sampsonbrasseux421/zynq-vision-sorting/report/video_script.docx

演示视频文本化说明

《基于 Zynq-7020 机械臂的智能识别与分拣》

## 一、视频基本信息

文件名 | 11月3日 (1).mp4
分辨率 | 1280 × 720
帧率 | 30 fps
时长 | 2 分 16 秒（135.9 秒）
内容概要 | 操作者用 Xbox 手柄手动操纵四轴机械臂，在传送带上完成色块抓取；HDMI 屏同时显示视觉识别面板与 PL 硬件 OSD。

## 二、分镜脚本

时间 | 画面内容 | 可配旁白 / 字幕
0:00–0:04 | 黑底白字标题卡：「基于 zynq7020 机械臂的智能识别与分拣」 | 本作品面向传送带色块分拣场景，以 Zynq-7020 为控制核心。
0:05–0:15 | 夹爪俯视特写，中央叠加红色十字标记「CLAW CENTER」，两侧蓝色夹指对称张开 | 夹爪由独立舵机驱动，PL 输出 50 Hz 硬件 PWM，脉宽 530 μs 合、1150 μs 开。
0:16–0:25 | HDMI 屏正面：顶栏 YOLO SORTING SYSTEM / ●BOARD / 18.0 FPS / MANUAL / ●REC；左侧绿色像素大字 STATE IDLE、TARGET、CENTER、BELT 9.45 MM/S、OK 0 FAULT 0；右侧信息栏含 TARGET、CENTER、BELT、LEAD、SUCCESS、FAULT、CYCLE、BOX L/R、VLM PICK | 屏上有两层界面：上层是 PC 渲染的状态面板，下层绿色文字是 PL 硬件字符 OSD，由 FPGA 逐像素生成，不占 CPU。
0:26–0:55 | 全景固定机位：左侧四轴机械臂与白色传送带，中间笔记本电脑，右侧操作者手持 Xbox 手柄操作摇杆与按键 | 机械臂支持手柄手动示教：左摇杆控制平面移动，右摇杆控制升降，步长随推杆力度在 1.5–12 mm 之间变化。
0:56–1:05 | 操作者持续操作手柄，机械臂在传送带上方移动、转向 | 每条运动命令经 TCP 送达 PS，由 PL 状态机自动组帧发送，单条耗时约 0.22 秒。
1:06–1:20 | 传送带出现红色与黄色方块，机械臂悬停上方；后方可见纸箱收纳盒与传送带电机 | 黄、蓝送左盒（+75°），红送右盒（−75°），黑、绿送斜后方（±110°）。
1:21–1:35 | 画面切换到绿色方块、黑色方块，机械臂姿态变化 | 视觉侧由 PC 端 YOLO 完成检测，逆运动学在 PS 侧解算，PL 负责时序与显示。
1:36–1:50 | 红色、黑色方块在传送带上，机械臂横向移动 | 抓取前先按目标方位收臂到 55% 半径，再转向，避免大半径横扫。
1:51–2:05 | 机械臂换姿态、下降，夹爪接近绿色方块 | 下降阶段使用运动预测，按传送带 9.45 mm/s 预估接触位置。
2:06–2:16 | 夹爪合拢夹起绿色方块，传送带上剩余黄色方块 | 完成一次抓取，夹爪脉宽由 1150 μs 切换到 530 μs。

## 三、完整解说词（可直接配音，约 2 分钟）

【0:00】 本作品是「基于 Zynq-7020 机械臂的智能识别与分拣系统」，面向传送带上彩色方块的分拣任务。

【0:05】 末端执行器是一对由舵机驱动的平行夹爪。舵机信号不经过操作系统调度，而是由 FPGA 内部产生 50 Hz 硬件 PWM，脉宽 530 微秒闭合、1150 微秒张开，控制周期稳定。

【0:16】 现场屏幕上有两层界面。上层是 PC 端渲染的状态面板，显示帧率、模式、目标坐标和计数；下层绿色文字是 PL 硬件字符 OSD——字模固化在 FPGA 内部，由逻辑逐像素查表渲染，即使 PC 断开也能独立显示板端状态。

【0:26】 系统支持 Xbox 手柄手动示教。左摇杆控制平面移动，右摇杆控制升降；步长随推杆力度在 1.5 到 12 毫米之间连续变化，轻推可做毫米级微调，推到底可快速大范围移动。

【0:56】 手柄指令经 TCP 送达 PS 端，逆运动学解算后写入 4 个目标脉冲数；组帧与发送时序全部由 PL 状态机完成，单条命令约 0.22 秒。

【1:06】 传送带上送入不同颜色的方块。系统按颜色分配到四个收纳盒：黄、蓝送左前方，红送右前方，黑、绿送两侧斜后方。

【1:21】 视觉由 PC 端 YOLO 完成检测，标定与传送带运动预测共同确定抓取点；PC 还会调用本地视觉语言模型，为「先抓哪一个」给出建议和理由。

【1:36】 为保证安全，机械臂在大角度换向前会先把手臂收拢到 55% 半径，再转向目标方位，避免伸展状态下横扫工作区。

【1:51】 接近阶段采用两段式：先到目标正上方，再垂直下降。传送带以约 9.45 毫米每秒运行，系统据此预测接触时刻的位置。

【2:06】 夹爪合拢，完成一次抓取；随后转向对应盒子、下降到放置高度、松爪并抬升，准备下一轮。

## 四、可作为报告「演示说明」的段落

演示视频完整记录了系统的手动示教与抓取过程。画面中同时可见三类信息：机械臂与传送带的物理动作、PC 端渲染的状态面板、以及 FPGA 内部生成的硬件字符 OSD。三者构成了「执行—显示—反馈」的完整闭环。

手动示教环节通过 Xbox 手柄实现，验证了运动链路的实时性：单条运动命令从 PC 发出到驱动器收到位置帧约 0.22 秒，摇杆操作到机械臂响应的延迟可用于精细定位。

抓取环节展示了颜色分拣逻辑、两段式接近策略以及大角度换向时的收臂保护，可作为系统功能完整性的直接证据。

## 五、视频中可截取的配图建议

用途 | 时间点 | 内容
封面 | 0:00 | 标题卡
系统总览 | 0:30 | 全景（机械臂 + 传送带 + 笔记本 + 手柄）
软件界面 | 0:18 | HDMI 屏正面，UI 与 PL OSD 同屏
末端执行器 | 0:08 | 夹爪特写
分拣场景 | 1:07 | 传送带上的红、黄方块
抓取瞬间 | 2:07 | 夹爪夹起绿色方块
