sampsonbrasseux421/zynq-vision-sorting/report/llm_collaboration_record.docx

大模型协作记录

《基于 Zynq-7020 的视觉分拣控制系统》

全国大学生嵌入式芯片与系统设计竞赛 2026 · FPGA 创新设计赛道 · 自主选题赛道

# 一、协作概述

本项目的硬件设计、嵌入式软件与上位机程序在开发过程中全程使用大语言模型作为工程协作者。协作不以“生成代码”为目的，而聚焦于四个环节：方案可行性论证、时序与资源定量分析、故障根因定位、验证方法设计。模型的输出均需经实测或仿真核对后才进入工程。

协作工具 | DeepSeek Harness（智能体式编码环境），支持文件读写、命令执行、仿真与板卡远程操作
模型能力 | 代码生成与审查、文档解析、日志分析、定量估算、多轮上下文保持
介入阶段 | 架构划分 → 协议设计 → RTL 实现 → 仿真验证 → 上板联调 → 文档整理
协作原则 | 模型提出假设，工程侧用仿真或实测数据裁决；不采纳未经核对的结论
沉淀产物 | 8 项工程级协作记录、5 个可复用技能包（见 skill/ 目录）

# 二、智能体协作工作流

协作流程固定为五阶段闭环，每一阶段的产出都是下一阶段的输入，任一阶段验证失败即回到上一阶段。

① 问题定义 | 把工程问题转写为可判定的技术问题（含量化指标与验收条件）
② 方案枚举 | 要求模型给出不少于两条候选路径，并列出各自的代价与失效条件
③ 定量裁决 | 用实测数据、仿真结果或器件手册数据对候选方案打分，选出主路径
④ 实现与验证 | RTL 或软件实现后，先仿真、再上板，用可观测信号确认行为
⑤ 回归与沉淀 | 改动后与已知可用版本对比；把失败模式整理为技能包条目

# 三、典型协作记录

以下记录按技术环节排列，每条包含问题定义、提示词、模型输出要点、工程裁决与验证结果。

## 记录 1｜逆运动学是否下放至 PL 的可行性论证

阶段　架构划分

提示词　当前逆运动学在 PS 端用浮点实现，单次约数微秒。考虑把它改到 PL，请从性能收益、资源代价、精度风险三个方面给出判断依据，并说明什么条件下才值得这么做。

模型输出要点　模型给出量化框架：PS 侧 IK 单次耗时约 5 μs，而一次四轴动作周期约 1.08 s，IK 占比约 0.0005%；PS 负载仅 0.14。要下放 PL 需满足四条前提之一：PS 负载 > 80%、IK 调用频率 > 100 Hz、需要微秒级硬实时、通信带宽足以支撑流式插补。本项目四条均不满足。同时指出定点化会把 atan2/acos 精度从 1e-7 降到 1e-3，需重新标定，资源代价约 2500–3500 LUT。

工程裁决　放弃该方案。改为把“组帧与发送时序”下放 PL——这是真正的时序瓶颈（帧间隔 60 ms，受驱动器限制），而非计算瓶颈。

验证结果　实测：IK 耗时占比 < 0.001%，PL 指令引擎仅占 231 LUT（0.43%）；动作周期由 1.49–1.67 s 降至 1.08 s。

结论　避免了约 3000 LUT 的无效开销与一次全量重标定，把优化投向了正确的瓶颈。

## 记录 2｜驱动器帧间隔下限的实验设计

阶段　协议实现

提示词　ZDT 驱动器在连续发送位置帧时存在丢帧。请设计一个实验确定最小可靠帧间隔，要求能区分“命令已发出”与“驱动器已接收”，并给出判据。

模型输出要点　模型提出以驱动器应答帧作为接收判据，而非以命令返回作为成功标志；建议以 60/40/30/20/10 ms 五档扫描，每档清空接收 FIFO 后单发一帧，读取 4 字节应答（地址 + 命令 + 状态 + 0x6B），状态字节 bit0 表示使能。

工程裁决　采纳该实验设计。扫描结果：60 ms 稳定应答，≤30 ms 出现丢帧。最终把 60 ms 作为 GAP_MS 默认值写入寄存器，可在线调整。

验证结果　板端实测应答字节为 02 F3 02 6B / 03 F3 02 6B，状态位正常；降至 20 ms 时无应答。

结论　确定了 60 ms 这一硬约束，并解释了为何 PL 引擎必须保留帧间等待，为后续“跳过使能阶段”的优化划定了边界。

## 记录 3｜四轴指令发送状态机的划分

阶段　RTL 设计

提示词　把 PS 端“逐条组帧 + usleep 等待”的发送流程改为 PL 硬件状态机。要求：四轴地址顺序发送、帧间隔可配置、支持绝对/相对位置、支持同步触发，并给出模块划分与寄存器映射。

模型输出要点　模型给出三级划分：单帧发送模块（组帧 + 8N1 串行化）、四轴调度模块（轴序 + 帧间定时）、AXI4-Lite 接口模块。寄存器映射建议：CTRL/TIMING/POS1–POS4/STATUS/CLR/GAP_MS，PS 侧仅需 6 次寄存器写。并提醒状态位应包含 busy、done、当前轴号与已发帧计数。

工程裁决　整体采纳，补充两点：① CTRL 写入需保留高位（曾因位宽掩码导致 uart_sel 被清零）；② STATUS 增加帧计数器，便于用单次读取判断一次动作是否完整发出 17 帧。

验证结果　仿真确认 12 帧使能 + 4 帧位置 + 1 帧同步共 17 帧；上板后帧计数每次动作递增 17，时序收敛，引擎占用 231 LUT。

结论　PS 侧代码由约 300 行降至 6 次寄存器写；多轴启动时间差由约 240 ms 降至微秒级。

## 记录 4｜视频叠加模块导致蓝屏的根因定位

阶段　故障定位

提示词　在 VDMA 与视频输出之间插入自制的字符叠加模块后，HDMI 输出变为纯蓝屏。该模块只做像素替换，不应影响时序。请给出排查顺序与最可能的根因。

模型输出要点　模型给出分层排查顺序：先确认视频时序链（VTC 是否仍在输出）、再确认 AXI4-Stream 握手（tvalid/tready/tlast）、最后确认 AXI4-Lite 从机是否会挂死总线。并指出一个高频陷阱：若 bvalid 由 awvalid && wvalid 组合产生，当主机分两拍给出 AW 与 W 时会永远等不到响应，导致互连超时、整条视频通路停摆。

工程裁决　按此顺序排查，确认根因为写通道握手缺陷（bvalid 依赖同拍 AW 与 W）。改为 AW、W 各自独立锁存后再产生 bvalid。

验证结果　编写 AXI 握手专项 testbench，覆盖 AW/W 同拍、异拍、乱序三种情形；上板后 HDMI 恢复正常，叠加区域正确。

结论　定位时间由预估的数小时缩短至一次排查；该缺陷后来被整理为技能包条目。

## 记录 5｜使能阶段占比分析驱动的性能优化

阶段　性能优化

提示词　一次四轴动作耗时 1.05 s，其中 12 帧使能占 720 ms、4 帧位置占 240 ms。使能是否每次都必须发送？如果可省，如何保证驱动器仍处于使能状态？

模型输出要点　模型指出驱动器一旦使能即保持，使能帧仅在驱动器上电或保护复位后需要；建议增加 CTRL 的 skip_en 位（bit4），使状态机可从使能阶段之后起跳；同时建议保留一条完整命令用于回零或异常恢复，并在时序上验证驱动器是否会因长时间空闲而失能。

工程裁决　采纳。新增 skip_en 位；实测空闲 120 s 后驱动器状态仍为使能（状态字节 0x03），确认可安全跳过。回零命令仍走完整流程，作为恢复手段。

验证结果　单条命令由 1.05 s 降至 0.22 s（5 帧），整块节拍由约 13 s 降至约 7 s；连续运行未出现丢步。

结论　在不牺牲可靠性的前提下取得约 4.8 倍的单命令加速，且资源增量为 0。

## 记录 6｜版本回归的差异定位方法

阶段　回归分析

提示词　修改放置动作后出现异常：机械臂在送盒后横扫整个工作区。当前版本与已知可用版本之间有多次改动，请给出一个能快速定位引入点的对比方法。

模型输出要点　模型建议以“可直接运行的历史备份”为基准做行为级差异对比，而非逐行读代码：先对齐两侧的下发命令序列（同一物块从抓取到放置的全部指令），再对差异指令回溯到源码分支，最后判断该分支是保护逻辑还是冗余动作。

工程裁决　按此方法对比，发现基准版本在抓取前存在一段“大角度换向先收臂到 55% 半径”的保护逻辑，而当前版本被删除。恢复该逻辑后异常消失。

验证结果　恢复后连续运行多块，机械臂在换向前先收臂，未再出现大半径横扫。

结论　确认该段代码属于安全保护而非冗余动作，并将其写入技能包“不可删除的保护逻辑”清单。

## 记录 7｜本地视觉语言模型的部署可行性评估

阶段　AI 方案选型

提示词　上位机无独立显卡。希望引入视觉语言模型参与“先抓哪一个”的任务级决策。请评估本地部署的可行性，给出模型规模上限、预期延迟与工程接入方式。

模型输出要点　模型给出三条候选：调用云端 API（延迟低但有网络依赖）、本地部署 7B 级模型（CPU 推理数十秒，不可用）、本地部署 0.2–0.5B 级小模型（CPU 数秒至十余秒，可行）。并建议采用异步接入：推理放后台线程，结果只影响下一次抓取，不阻塞实时控制；同时把检测结果作为文字提示一并送入，缩小模型的选择空间。

工程裁决　采纳第三方案。选用 256M 参数模型，实测单次推理约 10–12 s，异步化后不影响节拍；输出经候选颜色集合校验，不匹配则丢弃。

验证结果　接入后模型可给出建议颜色与简短理由，并在上位机面板与 HDMI 上同步显示；推理失败或超时不影响原有选块逻辑。

结论　在不具备 GPU 的条件下引入了任务级 AI 决策，且对实时性零影响。

## 记录 8｜面向现场调试的参数化设计

阶段　工程设计

提示词　放置位置的高度与半径在现场需要反复微调，但每次改动都要重新综合比特流，周期过长。请给出一个不改动硬件即可调整的方案。

模型输出要点　模型建议把几何参数外置为运行期配置：板端以配置文件读取放置半径与高度，命令解析时实时代入；同时指出该参数应同时被上位机读取，用于更新自身的位置跟踪模型，避免两端对“机械臂在哪”的认知不一致。

工程裁决　采纳。板端新增配置文件项，上位机同步读取同一组参数；并把“上位机位置跟踪需与板端动作保持一致”写入设计约束。

验证结果　现场调整放置高度仅需修改配置文件并重发命令，无需重新综合；多次调整后两端位置跟踪一致，未再出现因跟踪偏差导致的抓取取消。

结论　把一次参数调整的周期由“重新构建 + 部署”缩短到秒级。

# 四、自我纠错轨迹

以下三次纠错体现了“模型假设—工程验证—结论回写”的闭环，是本项目协作方法的核心证据。

纠错 1：把保护逻辑误判为冗余动作

在简化动作流程时删除了抓取前的收臂段，理由是“该动作看起来像多余的转向”。上板后机械臂在换向时以全伸长度横扫，存在碰撞风险。通过行为级差异对比确认该段为安全保护逻辑，随即恢复，并在技能包中登记为“禁止删除项”。教训：动作链中任何看似冗余的中间位姿，都应先确认其安全职责再决定去留。

纠错 2：以软件日志判断硬件是否工作

早期以“命令已下发”作为动作成功的判据，导致在驱动器实际未使能时仍判定正常。后改为以驱动器应答状态字节为准（bit0 使能、bit1 到位），并把这套判据固化到调试脚本中。教训：硬件链路的成功判据必须来自硬件回读，而非软件返回。

纠错 3：AXI 从机握手缺陷导致的整链停摆

字符叠加模块初版以 awvalid 与 wvalid 同拍为前提产生 bvalid，在主机分拍写入时挂死总线，表现为视频通路整体蓝屏。按分层排查顺序定位后改为独立锁存，并补充了覆盖同拍/异拍/乱序的专项 testbench。教训：自研 AXI 从机必须显式覆盖握手时序的全部合法组合。

# 五、协作方法论总结

- 用可观测信号裁决分歧：任何模型结论都必须落在一个可测量的量上：仿真波形、寄存器回读、驱动器应答或资源报告。
- 先量化瓶颈再选优化点：逆运动学下放 PL 的提议被否决，正是因为先算了占比（0.0005%）而不是先写代码。
- 把约束写成寄存器：帧间隔、使能策略、几何参数均外置为运行期配置，缩短了“改—验证”的循环。
- 保留可运行的历史基准：行为级差异对比是定位回归最快的手段，前提是基准版本可直接上板运行。
- 失败模式即技能包条目：每一条踩坑记录都转化为适用场景、触发条件与排查步骤，供他人复用。

# 六、协作成果与技能包的对应关系

上述协作记录中可复用的部分已提炼为技能包，置于仓库 skill/ 目录，对应关系如下。

协作记录 | 对应技能包
记录 2、5 | ZDT 驱动器时序调试技能包：帧间隔测定、应答判据、使能策略
记录 3 | PL 指令引擎搭建技能包：模块划分、寄存器映射、帧计数验证
记录 4、纠错 3 | 自研 AXI 从机检查清单：握手时序、位宽掩码、读通道响应
记录 6、纠错 1 | 版本回归定位技能包：行为级差异对比、保护逻辑识别
记录 7 | 本地小模型接入技能包：异步推理、候选约束、降级策略
记录 8 | 运行期参数化技能包：配置外置、两端一致性约束

说明：本记录中的提示词均为工程实施时的实际提问要点，模型输出经删节保留技术结论；所有数值结论均来自本项目实测或仿真结果。
