sampsonbrasseux421/zynq-vision-sorting/board/measured/cycle_log.csv

index | elapsed_s | steps_ok | steps_total
1 | 2.67 | 6 | 6
2 | 2.63 | 6 | 6
3 | 2.63 | 6 | 6
4 | 2.65 | 6 | 6
5 | 2.66 | 6 | 6
6 | 2.64 | 6 | 6
7 | 2.63 | 6 | 6
8 | 2.65 | 6 | 6
9 | 2.65 | 6 | 6
10 | 2.66 | 6 | 6
