sampsonbrasseux421/zynq-vision-sorting/board/measured/move_log.csv

index | mode | command | reply | elapsed_ms | ok
1 | full | 250 0 150 | OK GOTO 250 0 150 | 1008.0 | 1
2 | full | 250 0 150 | OK GOTO 250 0 150 | 1020.1 | 1
3 | full | 250 0 150 | OK GOTO 250 0 150 | 1018.0 | 1
4 | full | 250 0 150 | OK GOTO 250 0 150 | 1007.5 | 1
5 | full | 250 0 150 | OK GOTO 250 0 150 | 1007.3 | 1
6 | full | 250 0 150 | OK GOTO 250 0 150 | 1017.5 | 1
7 | full | 250 0 150 | OK GOTO 250 0 150 | 1021.5 | 1
8 | full | 250 0 150 | OK GOTO 250 0 150 | 1007.2 | 1
9 | full | 250 0 150 | OK GOTO 250 0 150 | 1007.3 | 1
10 | full | 250 0 150 | OK GOTO 250 0 150 | 1018.4 | 1
