sampsonbrasseux421/zynq-vision-sorting/board/measured/move_log_fast.csv

index | mode | command | reply | elapsed_ms | ok
1 | fast | 250 0 150 | OK GOTO 250 0 150 | 233.3 | 1
2 | fast | 250 0 150 | OK GOTO 250 0 150 | 233.5 | 1
3 | fast | 250 0 150 | OK GOTO 250 0 150 | 225.3 | 1
4 | fast | 250 0 150 | OK GOTO 250 0 150 | 230.6 | 1
5 | fast | 250 0 150 | OK GOTO 250 0 150 | 230.7 | 1
6 | fast | 250 0 150 | OK GOTO 250 0 150 | 220.9 | 1
7 | fast | 250 0 150 | OK GOTO 250 0 150 | 227.0 | 1
8 | fast | 250 0 150 | OK GOTO 250 0 150 | 231.2 | 1
9 | fast | 250 0 150 | OK GOTO 250 0 150 | 220.9 | 1
10 | fast | 250 0 150 | OK GOTO 250 0 150 | 231.5 | 1
