sampsonbrasseux421/zynq-vision-sorting/src/rtl/zdt_top21.v

//=============================================================================
// zdt_top21.v -- Four-axis ZDT controller with an 8-bit AXI-Lite address bus.
// The 8-bit local address is required for registers at offsets 0x40 and 0x48.
//=============================================================================
`default_nettype none

module zdt_top21 #(
    parameter integer CLK_HZ = 50_000_000,
    parameter integer BAUD   = 115200
) (
    (* X_INTERFACE_INFO = "xilinx.com:signal:clock:1.0 aclk CLK" *)
    (* X_INTERFACE_PARAMETER = "XIL_INTERFACENAME aclk,ASSOCIATED_BUSIF S_AXI,ASSOCIATED_RESET aresetn" *)
    input  wire        aclk,
    (* X_INTERFACE_INFO = "xilinx.com:signal:reset:1.0 aresetn RST" *)
    (* X_INTERFACE_PARAMETER = "XIL_INTERFACENAME aresetn,POLARITY ACTIVE_LOW" *)
    input  wire        aresetn,

    (* X_INTERFACE_INFO = "xilinx.com:interface:aximm:1.0 S_AXI AWADDR" *)
    (* X_INTERFACE_PARAMETER = "XIL_INTERFACENAME S_AXI,PROTOCOL AXI4LITE,DATA_WIDTH 32,ADDR_WIDTH 8,NUM_READ_OUTSTANDING 1,NUM_WRITE_OUTSTANDING 1,READ_WRITE_MODE READ_WRITE,HAS_BURST 0,HAS_LOCK 0,HAS_CACHE 0,HAS_REGION 0,HAS_QOS 0,HAS_PROT 0" *)
    input  wire [7:0]  s_axi_awaddr,
    (* X_INTERFACE_INFO = "xilinx.com:interface:aximm:1.0 S_AXI AWVALID" *)
    input  wire        s_axi_awvalid,
    (* X_INTERFACE_INFO = "xilinx.com:interface:aximm:1.0 S_AXI AWREADY" *)
    output wire        s_axi_awready,
    (* X_INTERFACE_INFO = "xilinx.com:interface:aximm:1.0 S_AXI WDATA" *)
    input  wire [31:0] s_axi_wdata,
    (* X_INTERFACE_INFO = "xilinx.com:interface:aximm:1.0 S_AXI WSTRB" *)
    input  wire [3:0]  s_axi_wstrb,
    (* X_INTERFACE_INFO = "xilinx.com:interface:aximm:1.0 S_AXI WVALID" *)
    input  wire        s_axi_wvalid,
    (* X_INTERFACE_INFO = "xilinx.com:interface:aximm:1.0 S_AXI WREADY" *)
    output wire        s_axi_wready,
    (* X_INTERFACE_INFO = "xilinx.com:interface:aximm:1.0 S_AXI BRESP" *)
    output wire [1:0]  s_axi_bresp,
    (* X_INTERFACE_INFO = "xilinx.com:interface:aximm:1.0 S_AXI BVALID" *)
    output wire        s_axi_bvalid,
    (* X_INTERFACE_INFO = "xilinx.com:interface:aximm:1.0 S_AXI BREADY" *)
    input  wire        s_axi_bready,
    (* X_INTERFACE_INFO = "xilinx.com:interface:aximm:1.0 S_AXI ARADDR" *)
    input  wire [7:0]  s_axi_araddr,
    (* X_INTERFACE_INFO = "xilinx.com:interface:aximm:1.0 S_AXI ARVALID" *)
    input  wire        s_axi_arvalid,
    (* X_INTERFACE_INFO = "xilinx.com:interface:aximm:1.0 S_AXI ARREADY" *)
    output wire        s_axi_arready,
    (* X_INTERFACE_INFO = "xilinx.com:interface:aximm:1.0 S_AXI RDATA" *)
    output wire [31:0] s_axi_rdata,
    (* X_INTERFACE_INFO = "xilinx.com:interface:aximm:1.0 S_AXI RRESP" *)
    output wire [1:0]  s_axi_rresp,
    (* X_INTERFACE_INFO = "xilinx.com:interface:aximm:1.0 S_AXI RVALID" *)
    output wire        s_axi_rvalid,
    (* X_INTERFACE_INFO = "xilinx.com:interface:aximm:1.0 S_AXI RREADY" *)
    input  wire        s_axi_rready,

    output wire        tx,
    output wire        uart_sel,
    output wire [15:0] status_frames,
    output wire        status_busy,
    output wire        status_done
);

    zdt_axil #(.CLK_HZ(CLK_HZ), .BAUD(BAUD)) u_zdt (
        .aclk(aclk), .aresetn(aresetn),
        .s_axi_awaddr(s_axi_awaddr), .s_axi_awvalid(s_axi_awvalid),
        .s_axi_awready(s_axi_awready),
        .s_axi_wdata(s_axi_wdata), .s_axi_wstrb(s_axi_wstrb),
        .s_axi_wvalid(s_axi_wvalid), .s_axi_wready(s_axi_wready),
        .s_axi_bresp(s_axi_bresp), .s_axi_bvalid(s_axi_bvalid),
        .s_axi_bready(s_axi_bready),
        .s_axi_araddr(s_axi_araddr), .s_axi_arvalid(s_axi_arvalid),
        .s_axi_arready(s_axi_arready),
        .s_axi_rdata(s_axi_rdata), .s_axi_rresp(s_axi_rresp),
        .s_axi_rvalid(s_axi_rvalid), .s_axi_rready(s_axi_rready),
        .tx(tx), .uart_sel(uart_sel), .status_frames(status_frames),
        .status_busy(status_busy), .status_done(status_done)
    );

endmodule

`default_nettype wire
