sampsonbrasseux421/zynq-vision-sorting/(commit log)

2026-11-03 Commit measured timing logs and drop the ignore rule
    [cycle_log.csv, move_log.csv, move_log_fast.csv]
2026-11-03 Add complete Vivado project and missing HDMI-path RTL
    [camera_hdmi_pins.xdc, camera_hdmi_top.v, camera_hdmi_top_tb.v, servo_pwm.v, system_wrapper.v, tmds_encoder.v, tmds_serializer.v]
2026-11-03 Correct stale pin comment in constraints
    [camera_hdmi_pins.xdc]
2026-11-04 Add PL-side inverse kinematics, Cartesian interpolation and S-curve planning
    - ik_solver.v: CORDIC (16-stage) + integer sqrt inverse kinematics, 13-state
    serial FSM; measured 2.4 us, zero jitter, 0.043 deg max deviation over 16 points
    - zdt_interp.v: Cartesian linear interpolation + quintic S-curve
    (s = 10u^3 - 15u^4 + 6u^5), zero collinearity error
    - zdt_axil.v: AXI registers, deg->pulse conversion (deg * PPR * 46603 >> 32),
    IK auto-trigger with absolute positioning
    - zdt_top21.v: top level with 8-bit AXI address bus (registers up to 0x40)
    - tb_ik_solver.v / tb_zdt_interp.v: simulation benches
    - docs/pl_ik_report.md: algorithm, verification and three debugging pitfalls
    - Clean up: dro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
    [ik_solver.v, tb_ik_solver.v, tb_zdt_axil.v, tb_zdt_axil_interp.v, tb_zdt_ik_axil.v, tb_zdt_interp.v, zdt_axil.v, zdt_interp.v]
2026-11-04 Add PS-side driver and on-board verification tools
    - ps/pik.sh: coordinate -> arm driver; writes X/Y/Z, triggers the PL solver,
    reads back joint angles. Includes the two's-complement write helper with
    read-back verification (devmem silently truncates negative values)
    - ps/README.md: register sequence and devmem pitfall
    - tools/final_ik_verify.py: 16-point on-board accuracy check (16/16, 0.043 deg)
    - tools/extract_ik_params.py: pull real kinematic parameters from the unstripped
    ik_zdt_pl ELF (parses .symtab + .data)
    - tools/fit_ik_params.py + ik_calib_samples.json: least-squares parameter fitting,
    kept as a negative result (2-link model does not match the real machine)
